AntonKyp/nrf24_comm_box/README.md

# nrf24_comm_box
A communication box which sends flight control commands to a quad copter
