AntonKyp/nrf24_comm_box/Mech/Connection_board/Ref/PCB drill dimensions.txt

Connector drills in board

Diameter = 1.8796
Drill = 1.016
