AntonKyp/nrf24_comm_box/Mech/Connection_board/Ref/doc_1563_2097.pdf

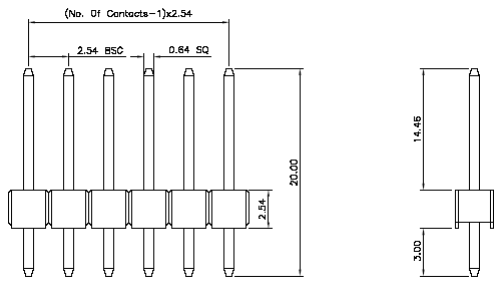
[picture p7: figure]
