AntonKyp/nrf24_comm_box/Mech/Connection_board/Ref/product_1180_4598_0x0.jpg

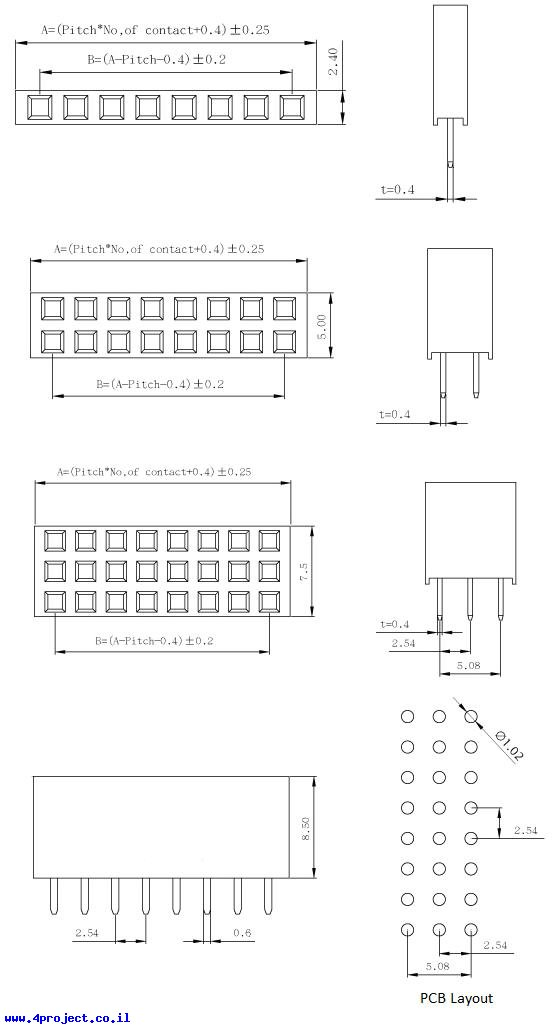
Mech/Connection_board/Ref/product_1180_4598_0x0.jpg
