AntonKyp/nrf24_comm_box/Mech/Enclosure/hole diam.png

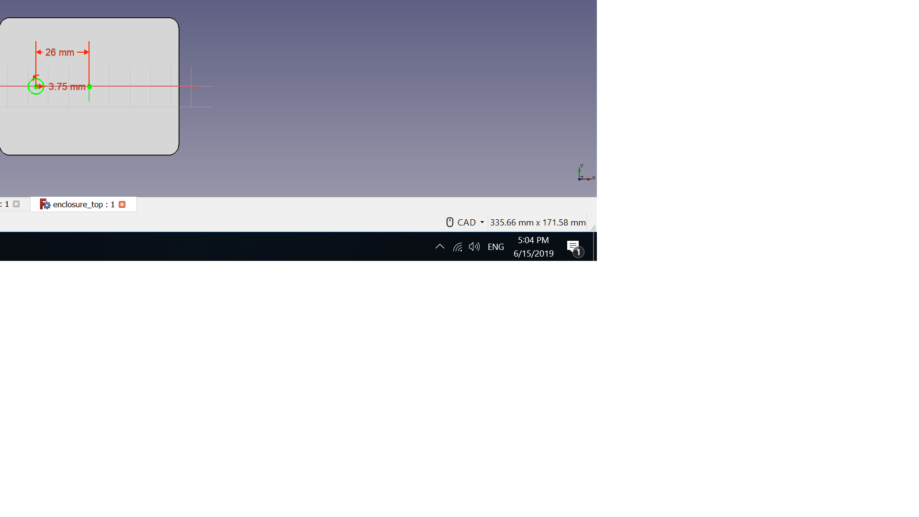
Mech/Enclosure/hole diam.png
