AntonKyp/nrf24_comm_box/Mech/Connection_board/connection_board.FCStd

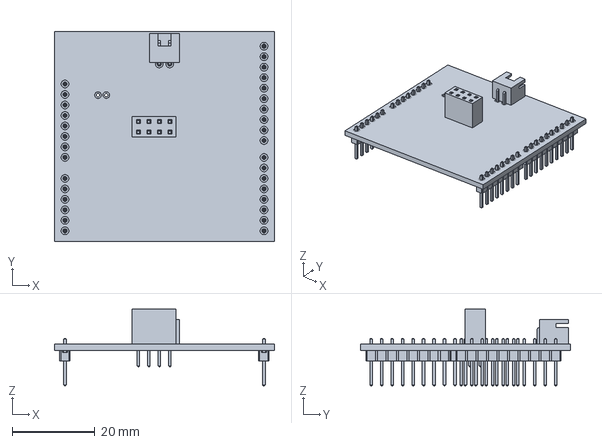
[picture p10: CAD file, 2020-08-19]
Mech/Connection_board/connection_board.FCStd
53.3 x 50.8 x 18.6 mm
