AntonKyp/nrf24_comm_box/Mech/Connection_board/Parts/8_pin_header_pth.step

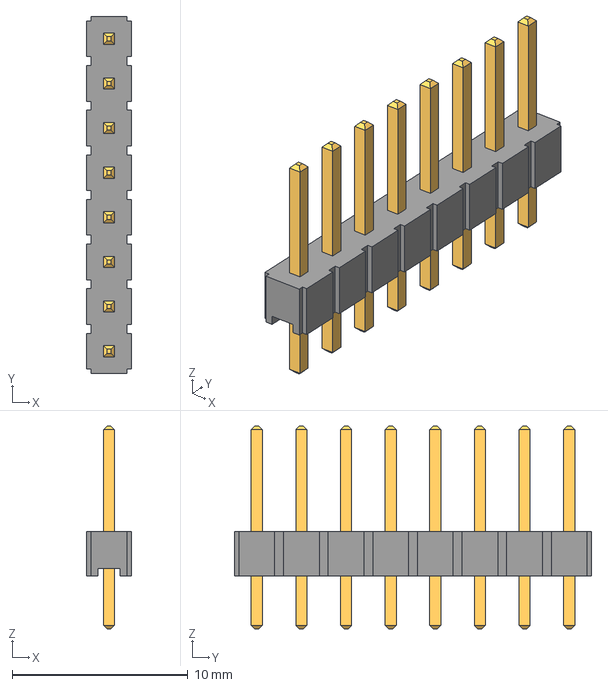
[picture p11: CAD file, 2020-08-19]
Mech/Connection_board/Parts/8_pin_header_pth.step
2.54 x 20.3 x 11.5 mm
