AntonKyp/nrf24_comm_box/Mech/Enclosure/enclosure_top.FCStd

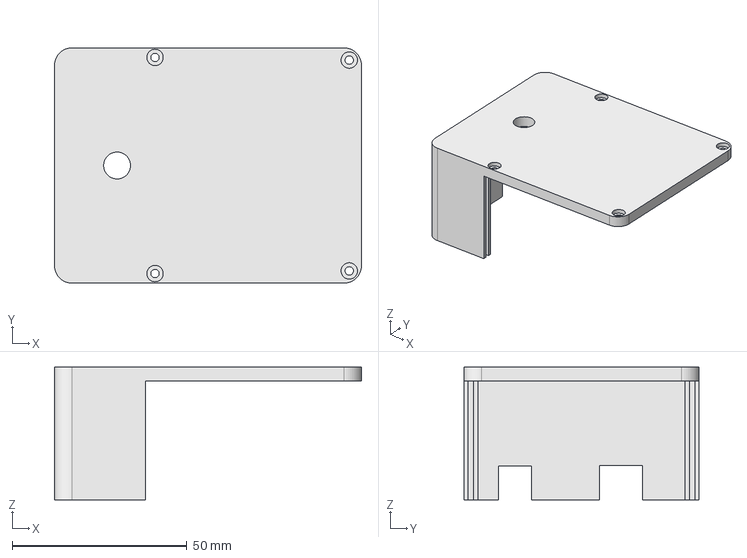
[picture p12: CAD file, 2020-08-19]
Mech/Enclosure/enclosure_top.FCStd
87.8 x 67.3 x 38.0 mm
