AntonKyp/nrf24_comm_box/Mech/NRF24/NRF24_basic.FCStd

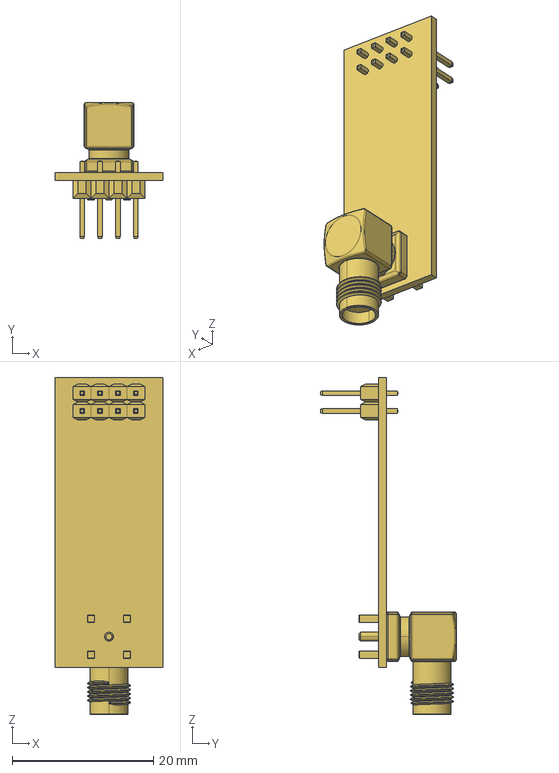
[picture p13: CAD file, 2020-08-19]
Mech/NRF24/NRF24_basic.FCStd
15.2 x 19.3 x 47.6 mm
