AntonKyp/nrf24_comm_box/Mech/Connection_board/Parts/temp.FCStd

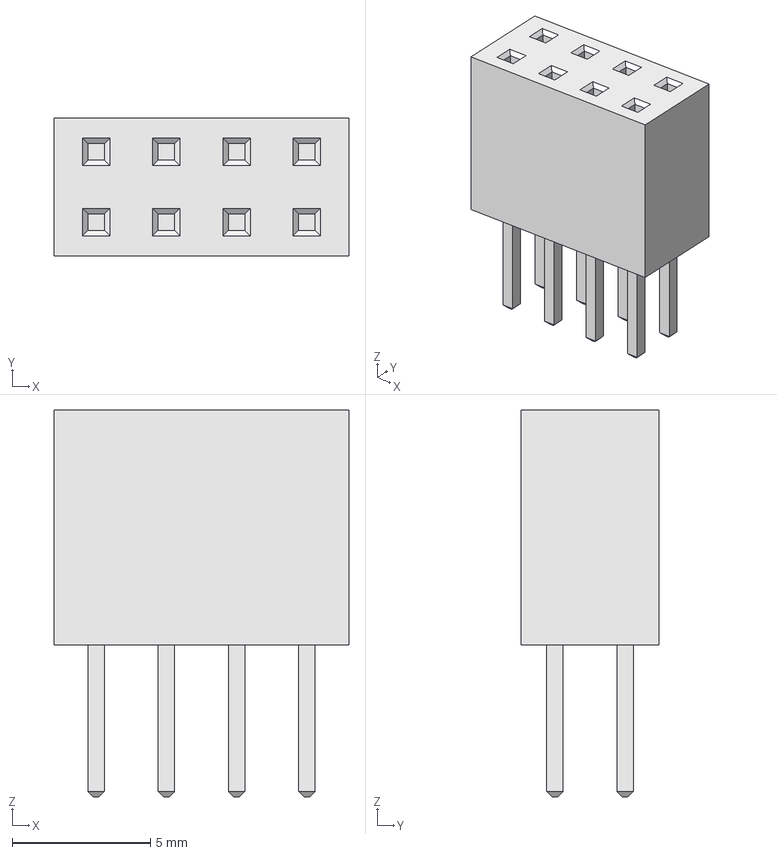
[picture p14: CAD file, 2020-08-19]
Mech/Connection_board/Parts/temp.FCStd
10.7 x 5.00 x 14.0 mm
