AntonKyp/nrf24_comm_box/Mech/Enclosure/enclosure_bottom.FCStd

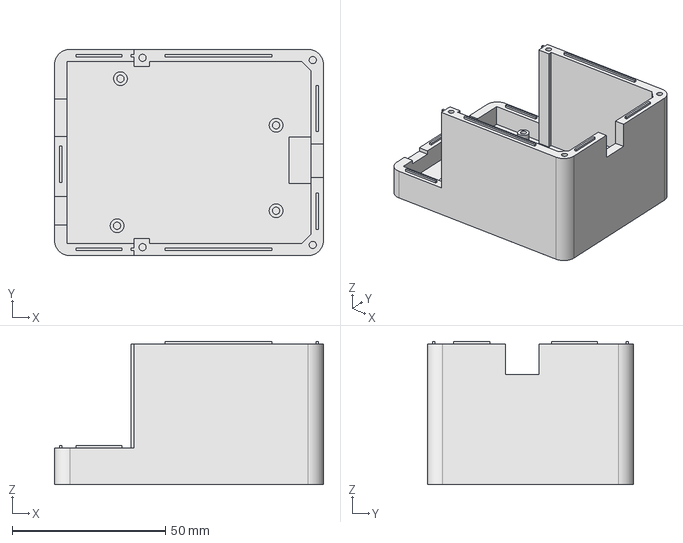
[picture p15: CAD file, 2020-08-19]
Mech/Enclosure/enclosure_bottom.FCStd
87.8 x 67.3 x 46.8 mm
