AntonKyp/nrf24_comm_box/Mech/Connection_board/Parts/JST_2_female.step

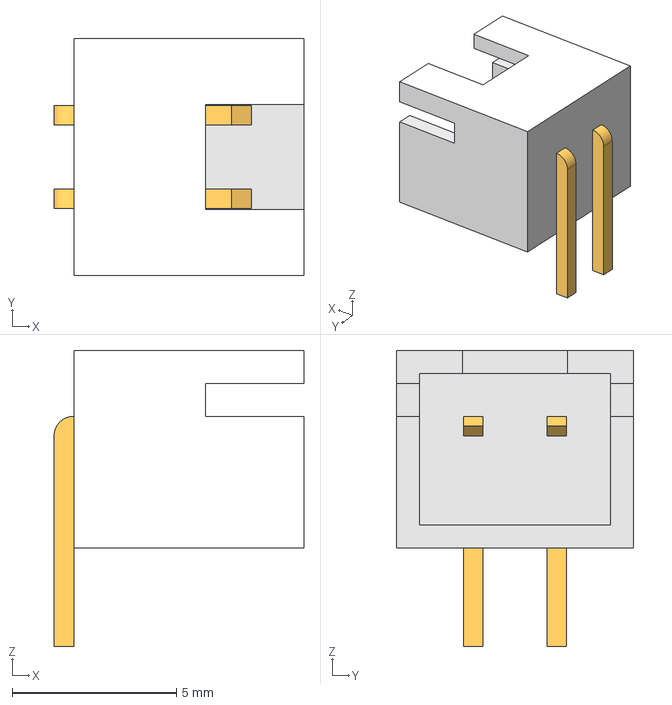
[picture p16: CAD file, 2020-08-19]
Mech/Connection_board/Parts/JST_2_female.step
7.60 x 7.20 x 9.00 mm
