AntonKyp/nrf24_comm_box/Mech/Connection_board/Parts/6_pin_connector.FCStd

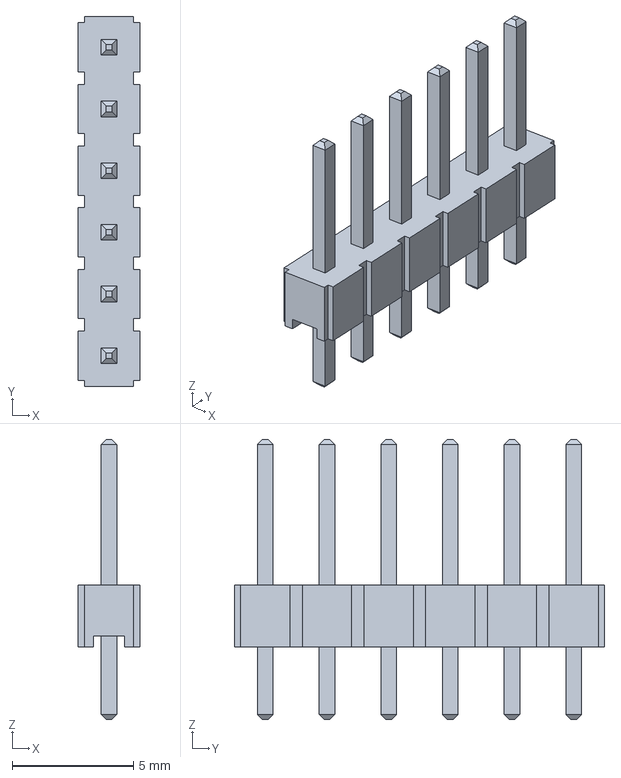
[picture p17: CAD file, 2020-08-19]
Mech/Connection_board/Parts/6_pin_connector.FCStd
2.54 x 15.2 x 11.5 mm
