AntonKyp/nrf24_comm_box/Mech/Connection_board/Parts/10_pin_header_pth.step

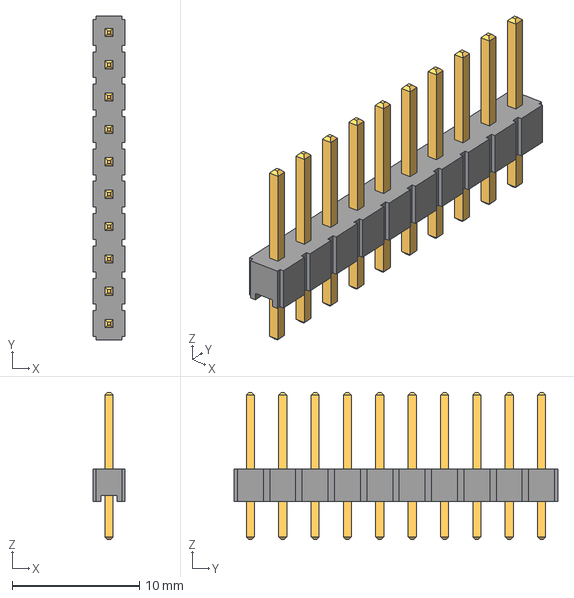
[picture p18: CAD file, 2020-08-19]
Mech/Connection_board/Parts/10_pin_header_pth.step
2.54 x 25.4 x 11.5 mm
