AntonKyp/nrf24_comm_box/(list of files, cad)

Other CAD files:
Mech/Connection_board/Parts/8_pin_connector.FCStd
Mech/Connection_board/Parts/6_pin_header_pth.step
Mech/Connection_board/Parts/2x4_female_connector.step
Mech/Connection_board/Parts/10_pin_connector.FCStd
Mech/Connection_board/Parts/JST_2_conn.FCStd
Mech/Connection_board/Parts/conn_board_pcb.FCStd
Mech/Connection_board/Parts/2x4_female_connector.FCStd
Mech/Enclosure/Enclosure_bottom.stl
Mech/Enclosure/enclosure_top.stl
