AntonKyp/nrf24_comm_box/Electrical/Connection_board.pdf

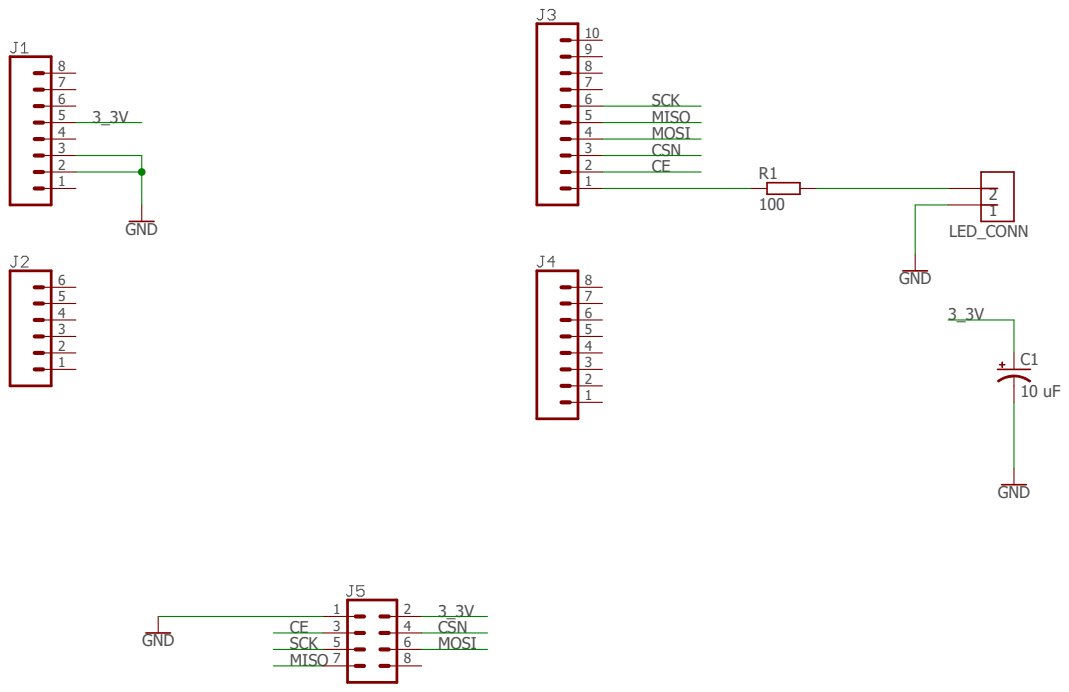
[picture p19: page 1]
GND; LED_CONN; CSN; MOSI; SCK; MISO

4/13/2019 5:45 PM C:\Users\Anton\Documents\eagle\Comm_system\Connection_board.sch (Sheet: 1/1)
