AntonKyp/nrf24_comm_box/Electrical/Connection_board.brd

## EAGLE design Electrical/Connection_board.brd (2020-08-19)

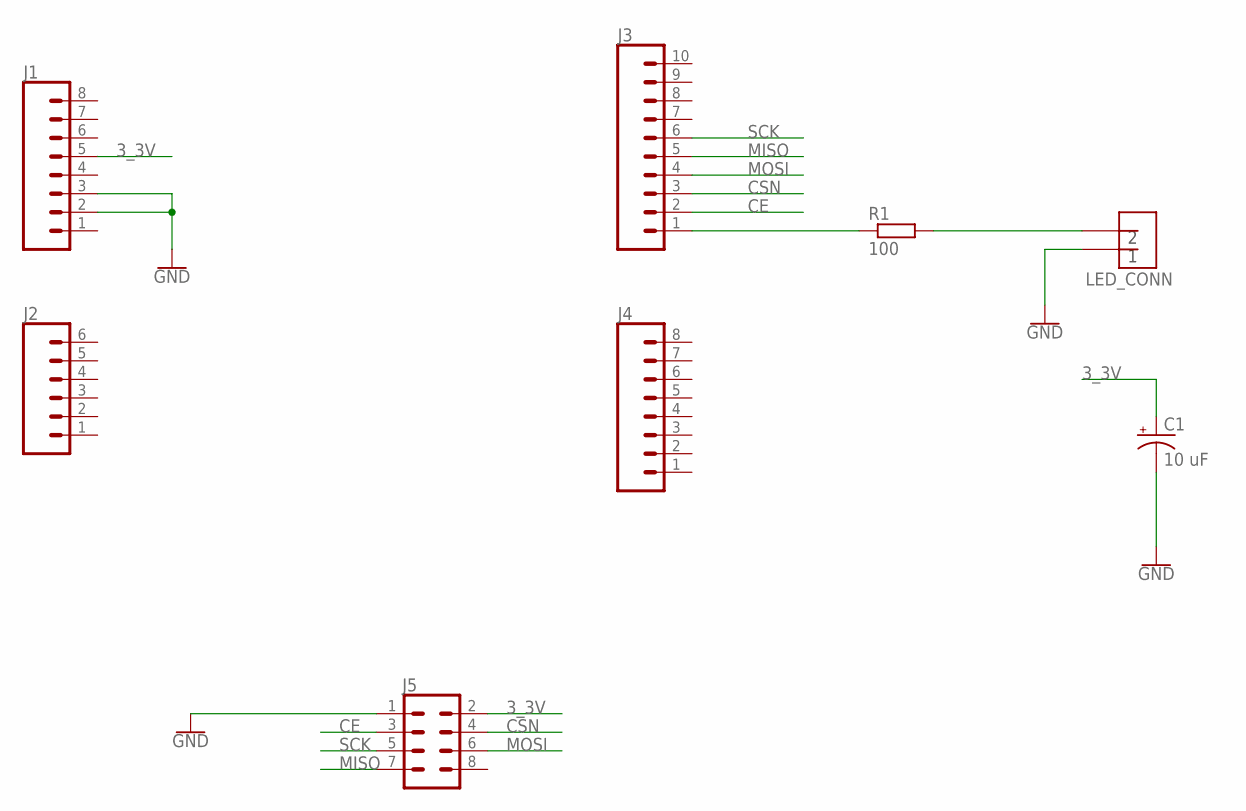
[picture p20: schematic Connection_board.sch]

Parts:
C1: 10 uF; E2-5
J1, J4: CONN_08"; 1X08
J2: CONN_06SILK_FEMALE_PTH; 1X06
J3: CONN_10"; 1X10
J5: CONN_04X2; 2X4
LED_CONN: JST_2
R1: 100; 0207/10

Connections:
3_3V: C1.+, J1.5, J5.2
CE: J3.2, J5.3
CSN: J3.3, J5.4
GND: C1.-, J1.2, J1.3, J5.1, LED_CONN.P$1
MISO: J3.5, J5.7
MOSI: J3.4, J5.6
unnamed: LED_CONN.P$2, R1.2
unnamed: J3.1, R1.1
SCK: J3.6, J5.5

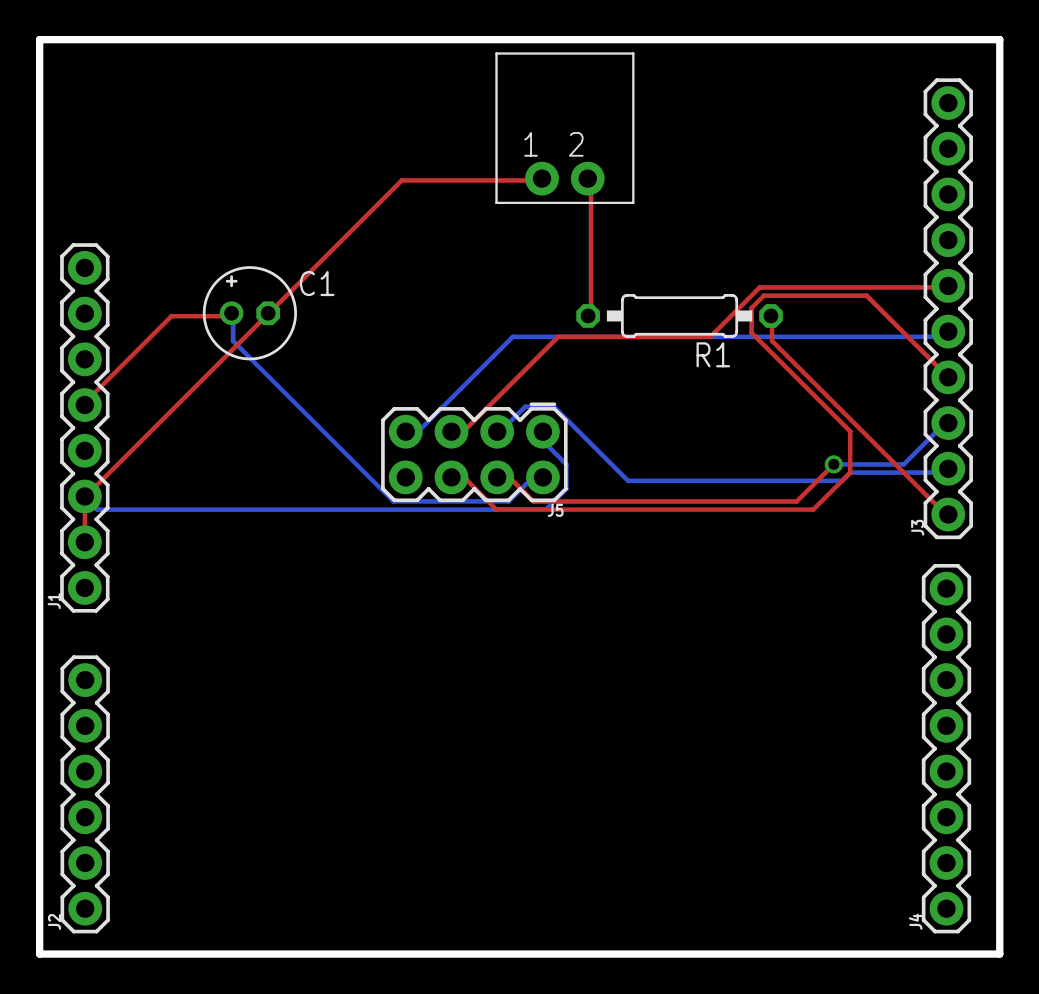
[picture p21: board Connection_board.brd from above]

Board: 2 copper layers, 53.3 x 50.8 mm, 8 parts (0 on the bottom side), 9 nets.
